Nathael/borne_arcade_fol/README

borne_arcade_fol
================

Borne Arcade pour la Fabrique d'Objets Libres
