Nathael/borne_arcade_fol/board_atmega/Nomenclature_borne arcade.ods

Composant | Description | Références | Doc | Nombre | Fabriquant |  | Fournisseur 1 |  |  | Prix |  |  |  | Total Achat | Total |  |  | Total Coût revient | Total
 |  |  |  |  | Nom | Ref | Nom | Ref | Min | Unit | Par 10 | Par 100 | Par 1000 | Unit | Par 10 | Par 100 | Par 1000 | Unit | Par 10 | Par 100 | Par 1000
Micro-contrôleur |  |  |  |  |  |  |  |  |  |  |  |  |  | 26,128 | 23,914 | 5,6203 | 4,5999 | 8,1014 | 7,3274 | 5,6203 | 4,5999
ATMega32U4 | atmel 8bits | U1 | 44TQFP | 1 | Atmel | ATMEGA32U4-AU | Farnell | 1748525 | 1 | 4,75 | 4 | 3 | 2,95 | 4,75 | 4 | 3 | 2,95 | 4,75 | 4 | 3 | 2,95
Condensateurs de découplage | Condos 0,1uF | C1, C3, C4 | 0603 | 3 | MULTICOMP | MC0603B104K500CT | Farnell | 1759122 | 10 | 0,009 | 0,009 | 0,008 | 0,006 | 0,09 | 0,09 | 0,024 | 0,018 | 0,027 | 0,027 | 0,024 | 0,018
Condensateurs | Condos 1uF | C2, C5 | 0603 | 2 | TDK | C1608X5R1H105K080AB | Farnell | 2211179 | 1 | 0,102 | 0,09 | 0,053 | 0,038 | 0,204 | 0,18 | 0,106 | 0,076 | 0,204 | 0,18 | 0,106 | 0,076
Condensateur filtrage | Condo 10uF | C7 | 0603 | 1 | MULTICOMP | MC0603X106M6R3CT | Farnell | 1759393 | 100 | 0,117 | 0,117 | 0,117 | 0,064 | 11,7 | 11,7 | 0,117 | 0,064 | 0,117 | 0,117 | 0,117 | 0,064
Résistances Pull-Up | Résistances 100k Ohms 1 % | R3, R4 .. R29 | 0603 | 27 | MULTICOMP | MC 0.063W 0603 1% 100K | Farnell | 9330402 | 50 | 0,035 | 0,035 | 0,035 | 0,022 | 1,75 | 1,75 | 0,945 | 0,594 | 0,945 | 0,945 | 0,945 | 0,594
Quartz CMS | 16MHz | X1 |  | 1 | TXC | 7B-16.000MAAJ-T | Farnell | 1841977 | 1 | 0,906 | 0,906 | 0,546 | 0,356 | 0,906 | 0,906 | 0,546 | 0,356 | 0,906 | 0,906 | 0,546 | 0,356
Condensateurs Quartz | 22pF | C6, C8 | 0603 | 2 | MULTICOMP | MCMT18N220F160CT | Farnell | 1856102 | 100 | 0,0237 | 0,0237 | 0,0237 | 0,0113 | 2,37 | 2,37 | 0,0474 | 0,0226 | 0,0474 | 0,0474 | 0,0474 | 0,0226
Résistance Led power | Résistances 1k Ohms 1 % | R30 | 0603 | 1 | MULTICOMP | MC 0.063W 0603 1% 1K | Farnell | 9330380 | 50 | 0,037 | 0,037 | 0,037 | 0,022 | 1,85 | 1,85 | 0,037 | 0,022 | 0,037 | 0,037 | 0,037 | 0,022
Led CMS rouge |  | D1 | 0603 | 1 | VISHAY | VLMS1300-GS08 | Farnell | 2251484 | 1 | 0,108 | 0,108 | 0,0979 | 0,0773 | 0,108 | 0,108 | 0,0979 | 0,0773 | 0,108 | 0,108 | 0,0979 | 0,0773
Switchs CMS | Switch CMS | SW1, SW2 |  | 2 | MULTICOMP | DTSM-32S-B | Farnell | 9471898 | 5 | 0,48 | 0,48 | 0,35 | 0,21 | 2,4 | 0,96 | 0,7 | 0,42 | 0,96 | 0,96 | 0,7 | 0,42
Prog USB |  |  |  |  |  |  |  |  |  |  |  |  |  | 2,89 | 2,602 | 0,657 | 0,407 | 0,874 | 0,874 | 0,657 | 0,407
Résistances USB | Résistances 22 Ohms 1 % | R1, R2 | 0603 | 2 | MULTICOMP | MC 0.063W 0603 1% 22R | Farnell | 9330844 | 50 | 0,036 | 0,036 | 0,036 | 0,022 | 1,8 | 1,8 | 0,072 | 0,044 | 0,072 | 0,072 | 0,072 | 0,044
Ferrite Alim USB | Perles de Ferrite 100MHz 600 Ohms | FB1 | 0603 | 1 | TDK | MMZ1608R601A | Farnell | 1669700 | 5 | 0,072 | 0,072 | 0,055 | 0,033 | 0,36 | 0,072 | 0,055 | 0,033 | 0,072 | 0,072 | 0,055 | 0,033
Micro-USB type A-B | CMS | P1 | CMS | 1 | MOLEX | 47590-0001 | Farnell | 1568022 | 1 | 0,73 | 0,73 | 0,53 | 0,33 | 0,73 | 0,73 | 0,53 | 0,33 | 0,73 | 0,73 | 0,53 | 0,33
Connecteurs GPIO |  |  |  |  |  |  |  |  |  |  |  |  |  | 1,56 | 1,15 | 1,02 | 0,83 | 1,56 | 1,15 | 1,02 | 0,83
Embases mâles GPIO | 30 voies au total | P2, P3 | 2,54mm | 1 | FISCHER | SL1.025.36Z | Farnell | 9729038 | 1 | 1,56 | 1,15 | 1,02 | 0,83 | 1,56 | 1,15 | 1,02 | 0,83 | 1,56 | 1,15 | 1,02 | 0,83
PCB |  |  |  |  |  |  |  |  |  |  |  |  |  | 10 | 1 | 0,8 | 0,8 | 2 | 1 | 0,8 | 0,8
PCB | 50mm x 50mm, 2 couches, vernis, sérigraphie |  |  | 1 |  |  | Seed Studio |  | 5 | 2 | 1 | 0,8 | 0,8 | 10 | 1 | 0,8 | 0,8 | 2 | 1 | 0,8 | 0,8
 | Nombre de composants : |  |  | 45
 | Nombre de composants CMS : |  |  | 47
 | Nombre de soudures : |  |  | 50 |  |  |  |  |  | HT | Composants + PCB |  |  |  |  | 8,0973 | 6,6369 |  | 10,3514 | 8,0973 | 6,6369
Fab
Assemblage | 10 minutes |  |  | 1 |  |  | Techno-Innov |  | 1 | 20 | 8 | 6 | 6 | 20 | 8 | 6 | 6
 |  |  |  |  |  |  |  |  |  | HT | Assemblé |  |  |  |  | 14,0973 | 12,6369
