Nathael/borne_arcade_fol/board_atmega/borne_arcade_atmega.kicad_pcb

## KiCad design board_atmega/borne_arcade_atmega.kicad_pcb (2014-11-10)

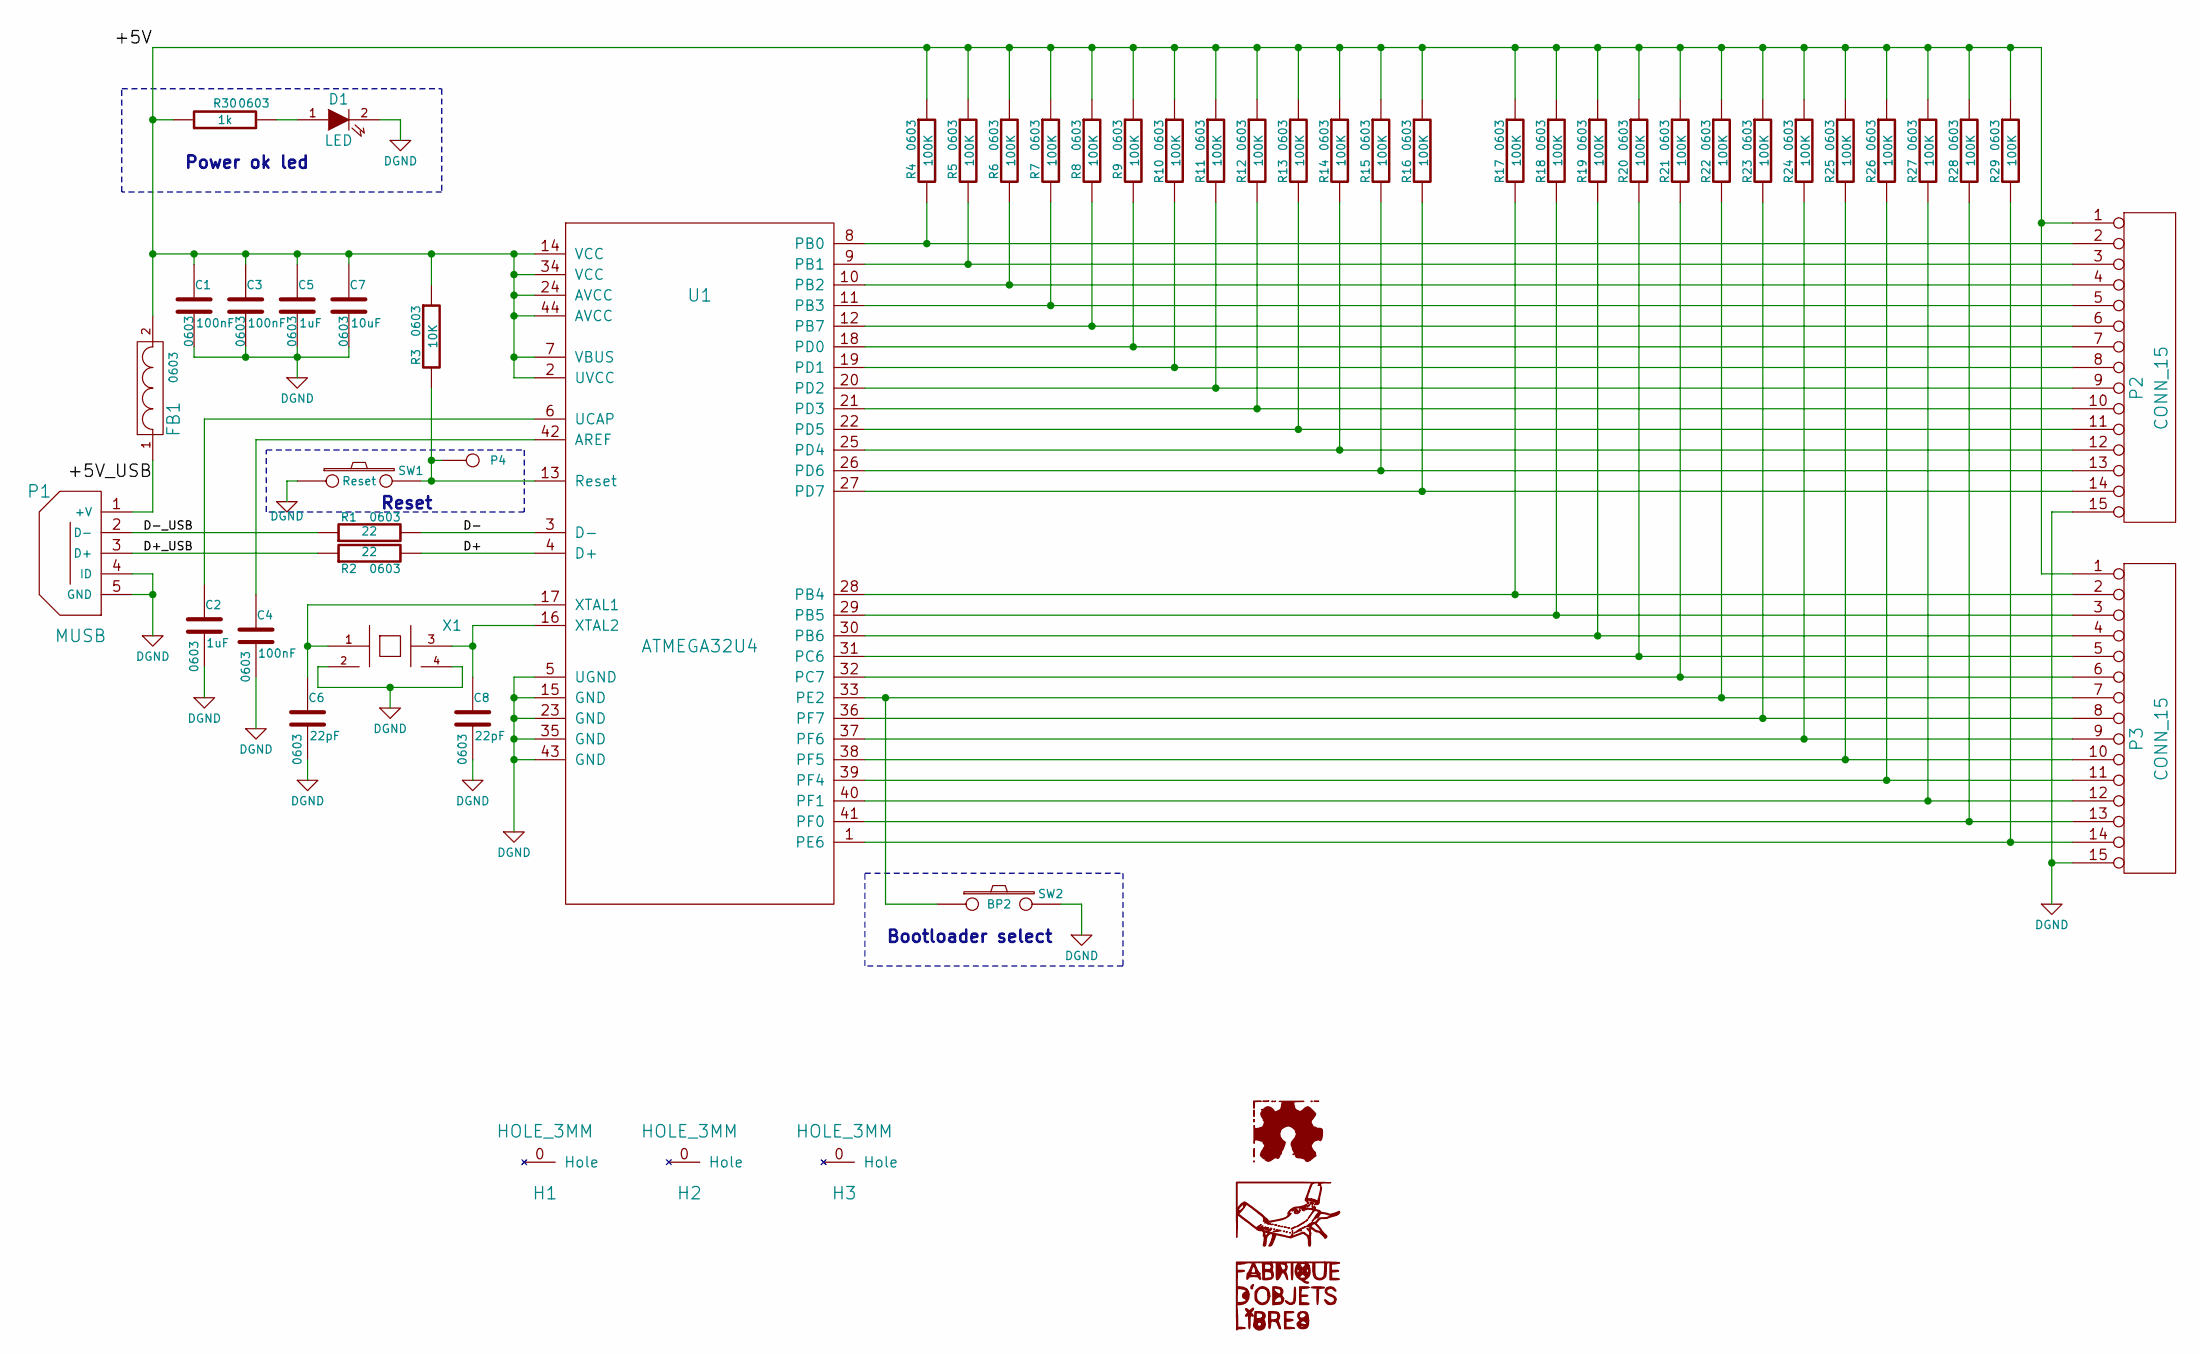
[picture p1: schematic borne_arcade_atmega.sch, Borne Arcade FOL ATMega]

Parts:
C1, C3, C4: 100nF; 0603
C2, C5: 1uF; 0603
C6, C8: 22pF; 0603
C7: 10uF; 0603
D1: LED
FB1: FILTER; 0603
G1: LOGO
G2: LOGO_FOL
G3: LOGO_OSHW
H1, H2, H3: HOLE_3MM
P1: MUSB
P2, P3: CONN_15
P4: CONN_1
R1, R2: 22; 0603
R3: 10K; 0603
R4, R5, R6, R7, R8, R9, R10, R11, R12, R13, R14, R15, R16, R17, R18, R19, R20, R21, R22, R23, R24, R25, R26, R27, R28, R29: 100K; 0603
R30: 1k; 0603
SW1: Reset
SW2: BP2
U1: ATMEGA32U4
X1: QUARTZ_CMS_4

Connections:
/+5V: C1.1, C3.1, C5.1, C7.1, FB1.2, P2.1, P3.1, R3.1, R4.1, R5.1, R6.1, R7.1, R8.1, R9.1, R10.1, R11.1, R12.1, R13.1, R14.1, R15.1, R16.1, R17.1, R18.1, R19.1, R20.1, R21.1, R22.1, R23.1, R24.1, R25.1, R26.1, R27.1, R28.1, R29.1, R30.1, U1.2 (UVCC), U1.7 (VBUS), U1.14 (VCC), U1.24 (AVCC), U1.34 (VCC), U1.44 (AVCC)
/+5V_USB: FB1.1, P1.1 (+V)
/D+: R2.2, U1.4 (D+)
/D+_USB: P1.3 (D+), R2.1
/D-: R1.2, U1.3 (D-)
/D-_USB: P1.2 (D-), R1.1
DGND: C1.2, C2.2, C3.2, C4.2, C5.2, C6.2, C7.2, C8.2, D1.2 (K), P1.4 (ID), P1.5 (GND), P2.15, P3.15, SW1.1, SW2.2, U1.5 (UGND), U1.15 (GND), U1.23 (GND), U1.35 (GND), U1.43 (GND), X1.2 (GND), X1.4 (GND)
unnamed: P2.9, R11.2, U1.20 (PD2)
unnamed: P2.8, R10.2, U1.19 (PD1)
unnamed: P2.7, R9.2, U1.18 (PD0)
unnamed: P2.6, R8.2, U1.12 (PB7)
unnamed: P2.5, R7.2, U1.11 (PB3)
unnamed: P2.4, R6.2, U1.10 (PB2)
unnamed: P2.3, R5.2, U1.9 (PB1)
unnamed: P2.2, R4.2, U1.8 (PB0)
unnamed: C2.1, U1.6 (UCAP)
unnamed: C8.1, U1.16 (XTAL2), X1.3
unnamed: P2.10, R12.2, U1.21 (PD3)
unnamed: P3.14, R29.2, U1.1 (PE6)
unnamed: D1.1 (A), R30.2
unnamed: P4.1, R3.2, SW1.2, U1.13 (Reset)
unnamed: P2.11, R13.2, U1.22 (PD5)
unnamed: P2.14, R16.2, U1.27 (PD7)
unnamed: P2.13, R15.2, U1.26 (PD6)
unnamed: P2.12, R14.2, U1.25 (PD4)
unnamed: P3.7, R22.2, SW2.1, U1.33 (PE2)
unnamed: P3.13, R28.2, U1.41 (PF0)
unnamed: P3.12, R27.2, U1.40 (PF1)
unnamed: P3.11, R26.2, U1.39 (PF4)
unnamed: P3.10, R25.2, U1.38 (PF5)
unnamed: P3.9, R24.2, U1.37 (PF6)
unnamed: P3.8, R23.2, U1.36 (PF7)
unnamed: P3.6, R21.2, U1.32 (PC7)
unnamed: P3.5, R20.2, U1.31 (PC6)
unnamed: P3.4, R19.2, U1.30 (PB6)
unnamed: P3.3, R18.2, U1.29 (PB5)
unnamed: P3.2, R17.2, U1.28 (PB4)
unnamed: C4.1, U1.42 (AREF)
unnamed: C6.1, U1.17 (XTAL1), X1.1

Notes on the sheet:
Power ok led
Bootloader select
Reset

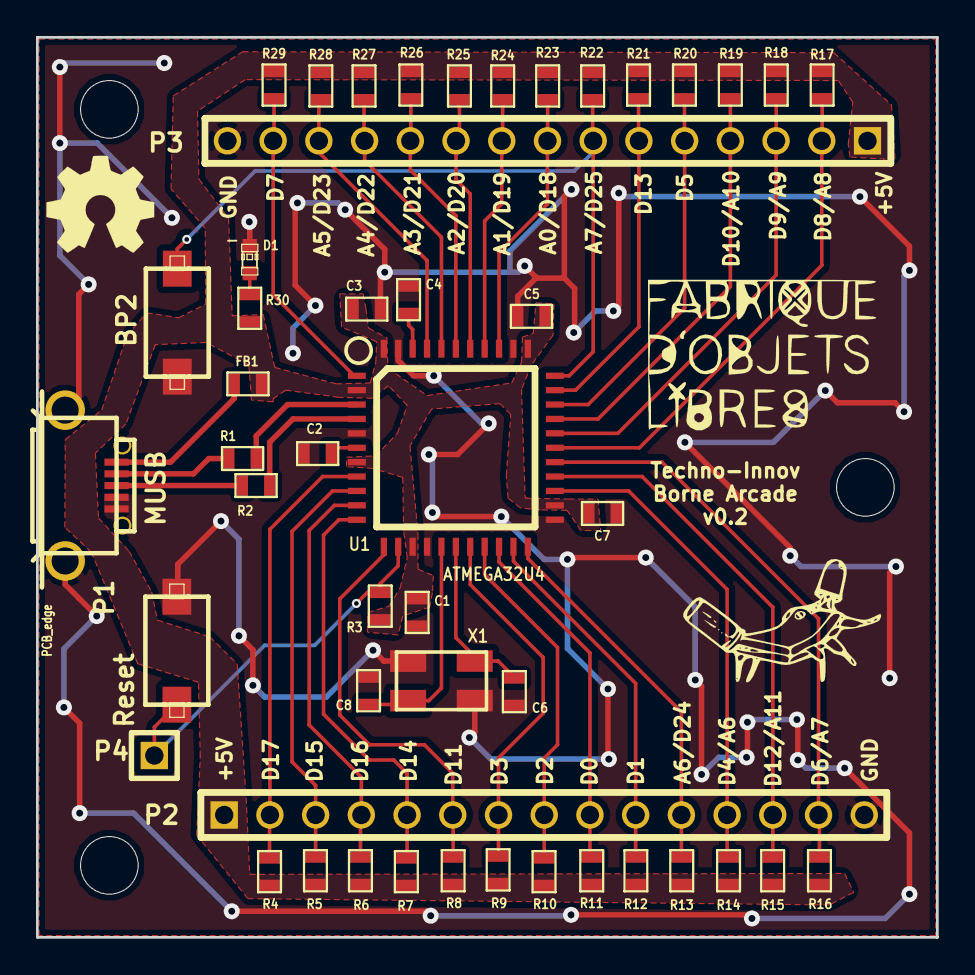
[picture p2: board borne_arcade_atmega.kicad_pcb from above]

Board: 2 copper layers, 50.0 x 50.0 mm, 54 parts (0 on the bottom side), 39 nets.
