Nathael/borne_arcade_fol/(commit log)

2014-07-08 Add kicad generated files to ignore list, and update for C compilation objects
2014-07-08 Base library comming from Techno-Innov's kicad library
2014-07-08 First draft of board, using ATMega32U4.
    [borne_arcade_atmega.kicad_pcb, borne_arcade_atmega.sch]
2014-07-08 Ajout des logos de la fabrique d'objets libres
2014-07-08 Adding page information (licence, version, author) Adding logos
    [borne_arcade_atmega.kicad_pcb, borne_arcade_atmega.sch]
2014-07-08 Adding footprints for 7b quartz and mini USB connector
2014-07-08 Allowing different parts to be under different licenses (mainly boards under CC-By-SA)
2014-07-08 Last missing footprint
2014-07-08 Layout and some modifications to ease layout
    [borne_arcade_atmega.kicad_pcb, borne_arcade_atmega.sch]
2014-07-17 First version produced
    [borne_arcade_atmega.kicad_pcb, borne_arcade_atmega.sch]
2014-11-10 Nev revision v0.2 : - Adding the switches for reset and ISP mode selection - Addind reset pin - Changed USB connector to micro-USB (was mini-USB) - Adding power led - Using "arduino" names on top sil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
    [borne_arcade_atmega.kicad_pcb, borne_arcade_atmega.sch]
2014-11-10 Adding BOM, with farnell refs.
    [Nomenclature_borne arcade.ods]
