Nathael/borne_arcade_fol/(notices)

Notices in the files:
board_atmega/borne_arcade_atmega.sch:
Licence : CC-By-SA
